angelongit/spot/docs/concept/concept_b_hex.png

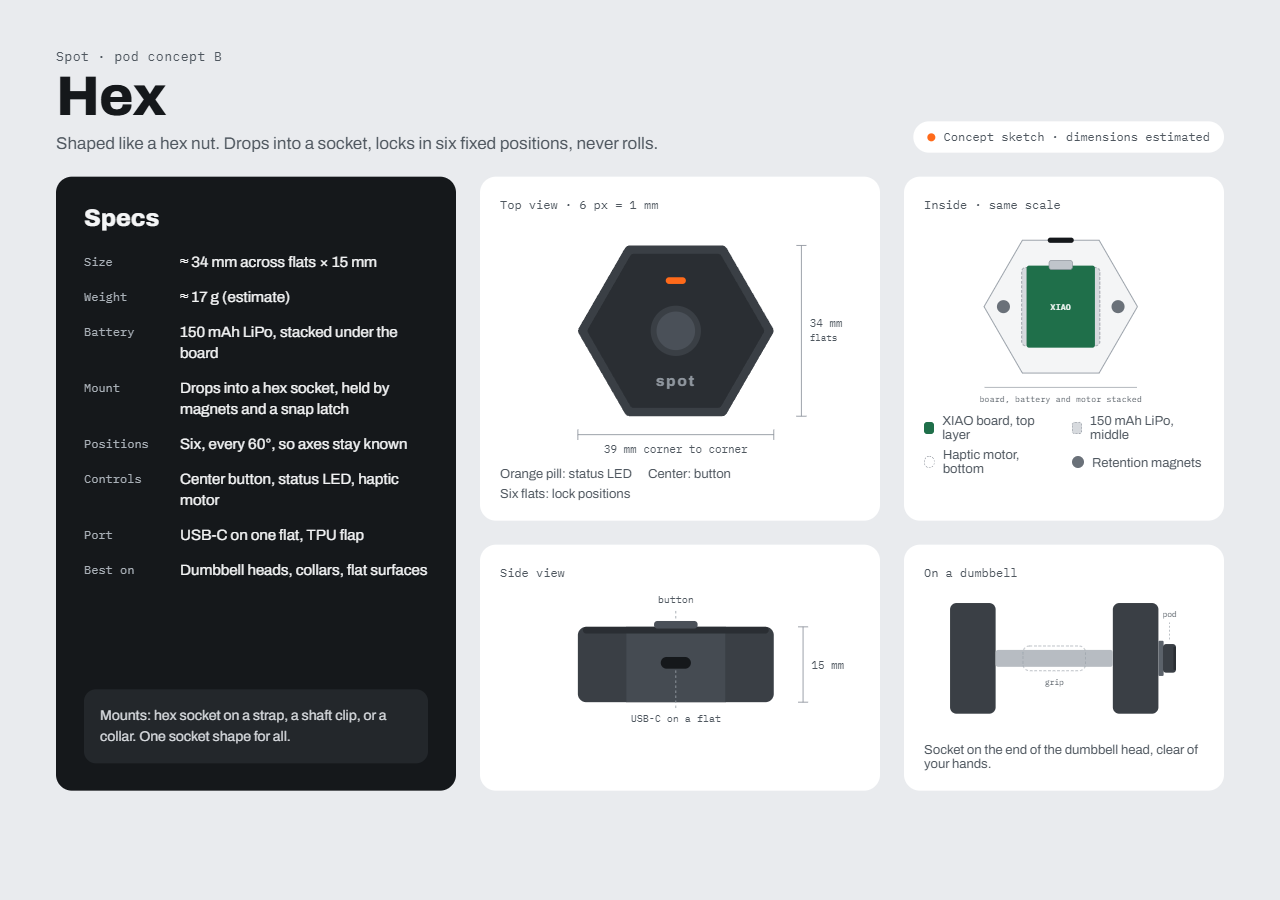
docs/concept/concept_b_hex.png
