angelongit/spot/docs/concept/hex_on_machines.png

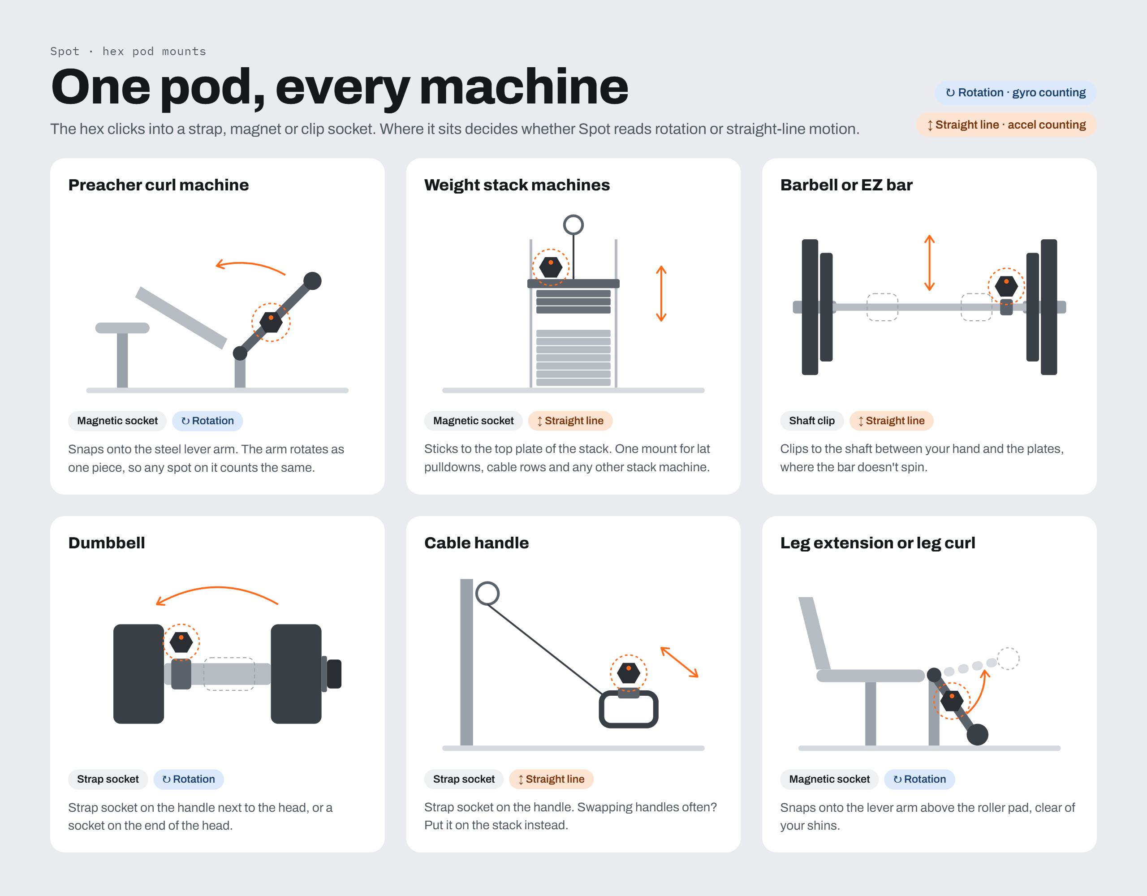
docs/concept/hex_on_machines.png
