angelongit/spot/docs/Spot_Test_Log_v1.2.xlsx

Sheet: Summary
Spot v1 test results (held-out data only)
Calculated from the other tabs. Only rows marked Held-out = Yes are counted. Do not edit this tab.
Measure | Curl | Raise | Press
R1 · held-out sets scored | 0 | 0 | 0
R1 · % of sets within ±1 (need ≥ 90%)
R1 · sets outside ±2 (need 0) | 0 | 0 | 0
R1 · PASS (≥ 27 sets, ≥ 90% within ±1, none outside ±2) | — | — | —
R4 · Spot mean absolute error
R4 · watch mean absolute error
R4 · PASS (Spot error lower than watch) | — | — | —
R3 · rest periods scored | 0 | 0 | 0
R3 · % within ±5 s (need ≥ 90%)
R3 · PASS (≥ 20 rests, ≥ 90% within ±5 s) | — | — | —
R2 · noise sets scored | 0 | 0 | 0
R2 · noise sets failed (need 0) | 0 | 0 | 0
R2 · PASS (≥ 20 sets, none failed) | — | — | —
R6a · % of reps within ±0.5 s (need ≥ 90%)
R6b · % of video partials logged as partials (need ≥ 90%)
R6b · % of full reps logged as partials (need ≤ 10%)
R6c · % of momentum reps flagged (need ≥ 80%)
R6c · % of clean reps flagged as momentum (need ≤ 10%)
Partials are not counted as reps. For the press, R6c momentum means a rebound off the chest. R5 and R7 are pass/fail checks recorded in the Project Log.

Sheet: How to use
How to use this test log
• Fill in only the light-orange cells. Row 2 of each tab (grey) is an example with Held-out = Example; it is never scored.
• White cells are formulas. Do not type over them.
• One row per set (R1 sets), per rest period (R3 rest), per noise recording (R2 noise) and per rep (R6 reps).
• Count reps on the video BEFORE looking at Spot's count, and type the video count first.
• Held-out? = Yes only for sets recorded after the counter was frozen (Git tag). Everything earlier is tuning data: mark it No.
• R1 sets: Difference = Spot count − video count. Watch count is only for R4; leave it blank otherwise.
• R3 rest: rest boundaries come from the video's counted reps, not Spot's. Mark Excluded? = Yes for any rest over 5 minutes, decided before scoring.
• R2 noise: Pass needs Spot count = 0 and Started a set? = No.
• R6 reps: one row per movement (full rep or partial). Video label is clean, momentum or partial, judged on video before looking at Spot's data. Rep duration (R6a) is scored on full reps only. Mark Excluded? = Yes for a rep the video shows did not follow its set type, decided before scoring.
• R1 sets: the video count is full reps only (momentum reps included). Partials go in the Video partials column.
• The Summary tab applies the pass rules from Spot — Requirements v1.0.
File name rule (see data/README.md): <exercise>_<hand>_<speed>_<form>_<NN>reps_<YYYYMMDD>_<HHMM>.csv, for example curl_R_normal_mixed_08reps_20261102_1405.csv

Sheet: R1 sets
Set ID | Date | File name | Exercise | Speed | Form | Planned reps | Video count (full reps) | Spot count | Difference (Spot − video) | Within ±1 | Within ±2 | Held-out? | Watch count (R4) | Watch error | Spot error | Hand | Video partials | Spot partials | Notes
EXAMPLE | 2026-11-02 | curl_R_normal_mixed_08reps_20261102_1405.csv | curl | normal | mixed | 8 | 8 | 9 | 1 | Yes | Yes | Example | 7 | 1 | 1 | R | 3 | 3 | Example row, not scored

Sheet: R3 rest
Rest ID | Exercise | Set before (ID) | Set after (ID) | Video rest (s) | Spot rest (s) | Difference (s) | Within ±5 s | Held-out? | Excluded? | Notes
EXAMPLE | curl | C-01 | C-02 | 92.4 | 95.1 | 2.7 | Yes | Example | No | Example row, not scored

Sheet: R2 noise
Noise ID | Mode | File name | Noise types | Between real sets? | Length (s) | Spot count | Started a set? | Pass | Held-out? | Notes
EXAMPLE | curl | curl_noise_pickup-carry_20261102_1420.csv | pick up, carry | No | 45 | 0 | No | Yes | Example | Example row, not scored

Sheet: R6 reps
Set ID | Movement # | Exercise | Video label | Video duration (s) | Spot duration (s) | Difference (s) | Within ±0.5 s | Spot logged as partial | LED cue correct? | Excluded? | Held-out? | Spot momentum flag | Notes
EXAMPLE | 1 | curl | momentum | 2.1 | 2.32 | 0.22 | Yes | No |  | No | Example | Yes | Example row, not scored
