angelongit/spot/data/tuning/Dumbbell_Curls/Initial_Testing/curl_momentum_10reps_20261016_210242.csv

t_ms | ax | ay | az | gx | gy | gz
1461191 | 0.214 | 0.971 | -0.109 | 0.00 | -2.52 | -2.80
1461201 | 0.217 | 0.965 | -0.108 | 0.35 | -2.94 | -3.01
1461211 | 0.218 | 0.960 | -0.109 | 0.91 | -3.29 | -3.57
1461220 | 0.220 | 0.956 | -0.108 | 1.40 | -3.64 | -4.13
1461230 | 0.224 | 0.954 | -0.105 | 1.54 | -3.64 | -4.48
1461240 | 0.224 | 0.951 | -0.107 | 2.03 | -3.78 | -4.27
1461250 | 0.224 | 0.952 | -0.107 | 2.87 | -3.92 | -2.80
1461260 | 0.232 | 0.961 | -0.108 | 3.43 | -3.99 | -0.56
1461270 | 0.233 | 0.962 | -0.107 | 4.20 | -3.92 | 1.75
1461280 | 0.231 | 0.960 | -0.111 | 4.62 | -3.71 | 3.92
1461290 | 0.231 | 0.959 | -0.113 | 5.53 | -3.71 | 6.23
1461300 | 0.233 | 0.962 | -0.111 | 5.88 | -3.57 | 8.05
1461311 | 0.232 | 0.962 | -0.111 | 6.37 | -3.43 | 10.15
1461321 | 0.229 | 0.963 | -0.114 | 7.14 | -3.29 | 11.76
1461334 | 0.231 | 0.966 | -0.116 | 7.49 | -3.29 | 12.67
1461344 | 0.232 | 0.969 | -0.118 | 7.70 | -3.15 | 12.88
1461354 | 0.229 | 0.968 | -0.119 | 7.77 | -3.08 | 12.67
1461363 | 0.224 | 0.974 | -0.119 | 8.05 | -3.22 | 11.83
1461373 | 0.221 | 0.976 | -0.118 | 8.05 | -3.36 | 10.57
1461383 | 0.214 | 0.978 | -0.115 | 8.19 | -3.64 | 9.31
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
