angelongit/spot/data/tuning/Dumbbell_Curls/Initial_Testing/curl_normal_set_10_reps.csv

t_ms | ax | ay | az | gx | gy | gz
5677 | -0.074 | 0.995 | 0.001 | 2.94 | -7.00 | -0.21
5687 | -0.074 | 0.996 | -0.001 | 3.15 | -6.86 | 0.00
5697 | -0.073 | 0.996 | 0.003 | 3.36 | -6.79 | 0.77
5707 | -0.075 | 0.997 | 0.000 | 3.29 | -6.72 | 1.26
5718 | -0.078 | 0.996 | 0.003 | 3.64 | -6.72 | 1.96
5727 | -0.082 | 0.995 | 0.005 | 3.78 | -6.86 | 2.45
5737 | -0.084 | 0.991 | 0.004 | 3.78 | -7.00 | 2.87
5746 | -0.087 | 0.990 | 0.004 | 4.27 | -7.42 | 3.57
5756 | -0.093 | 0.989 | 0.005 | 4.13 | -7.77 | 4.48
5766 | -0.100 | 0.990 | 0.008 | 4.41 | -8.26 | 5.53
5776 | -0.107 | 0.993 | 0.008 | 4.97 | -9.17 | 6.65
5785 | -0.114 | 0.991 | 0.009 | 5.11 | -10.01 | 7.77
5795 | -0.117 | 0.994 | 0.013 | 5.39 | -11.34 | 9.03
5805 | -0.123 | 0.993 | 0.011 | 5.95 | -12.53 | 9.59
5815 | -0.128 | 0.992 | 0.011 | 6.30 | -13.79 | 9.73
5825 | -0.133 | 0.989 | 0.009 | 6.30 | -15.19 | 9.03
5834 | -0.140 | 0.987 | 0.009 | 6.51 | -16.73 | 7.77
5844 | -0.143 | 0.986 | 0.006 | 5.88 | -18.13 | 6.79
5854 | -0.145 | 0.987 | 0.006 | 5.46 | -19.53 | 5.67
5863 | -0.145 | 0.989 | 0.004 | 4.76 | -21.28 | 4.83
5874 | -0.142 | 0.991 | -0.000 | 4.34 | -22.61 | 4.55
5884 | -0.136 | 0.994 | 0.002 | 3.64 | -23.80 | 5.25
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
