angelongit/spot/data/tuning/Dumbbell_Curls/Initial_Testing/curl_normal_set_12_reps.csv

t_ms | ax | ay | az | gx | gy | gz
820802 | 0.859 | -0.469 | 0.078 | -3.85 | -2.87 | 9.03
820812 | 0.862 | -0.467 | 0.076 | -3.29 | -3.08 | 10.92
820822 | 0.864 | -0.464 | 0.068 | -3.29 | -3.08 | 12.11
820832 | 0.869 | -0.468 | 0.068 | -2.73 | -3.08 | 12.88
820841 | 0.879 | -0.472 | 0.068 | -2.45 | -3.08 | 13.58
820851 | 0.885 | -0.476 | 0.066 | -2.31 | -3.01 | 13.44
820861 | 0.886 | -0.473 | 0.065 | -1.96 | -2.80 | 12.60
820872 | 0.884 | -0.470 | 0.061 | -1.89 | -2.59 | 11.83
820881 | 0.887 | -0.468 | 0.061 | -1.68 | -2.24 | 11.48
820892 | 0.891 | -0.471 | 0.063 | -1.54 | -1.96 | 11.27
820902 | 0.896 | -0.474 | 0.063 | -1.54 | -1.68 | 11.34
820911 | 0.896 | -0.472 | 0.063 | -2.03 | -1.40 | 11.27
820922 | 0.897 | -0.470 | 0.067 | -2.17 | -1.26 | 10.78
820931 | 0.897 | -0.468 | 0.070 | -2.73 | -1.33 | 9.59
820942 | 0.896 | -0.462 | 0.072 | -3.50 | -1.26 | 7.98
820951 | 0.895 | -0.455 | 0.075 | -4.97 | -1.26 | 6.30
820961 | 0.893 | -0.447 | 0.082 | -6.23 | -1.26 | 4.48
820971 | 0.887 | -0.444 | 0.083 | -7.56 | -1.19 | 2.66
820981 | 0.884 | -0.434 | 0.083 | -8.89 | -1.26 | 1.05
820991 | 0.879 | -0.432 | 0.082 | -10.29 | -1.26 | 0.21
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
