angelongit/spot/data/tuning/Dumbbell_Curls/Initial_Testing/curl_normal_set_8_reps.csv

t_ms | ax | ay | az | gx | gy | gz
778913 | 0.610 | -0.791 | -0.043 | 1.75 | -10.01 | 0.77
778923 | 0.610 | -0.793 | -0.044 | 1.89 | -10.08 | 1.26
778933 | 0.608 | -0.795 | -0.045 | 1.89 | -10.15 | 1.89
778942 | 0.611 | -0.798 | -0.046 | 2.10 | -10.22 | 2.73
778952 | 0.610 | -0.802 | -0.044 | 1.89 | -10.15 | 3.50
778961 | 0.610 | -0.800 | -0.045 | 2.10 | -10.08 | 3.85
778971 | 0.609 | -0.798 | -0.044 | 2.17 | -10.08 | 3.99
778981 | 0.609 | -0.800 | -0.045 | 2.17 | -10.15 | 3.71
778991 | 0.602 | -0.799 | -0.040 | 2.24 | -10.01 | 3.15
779001 | 0.603 | -0.796 | -0.042 | 2.17 | -9.87 | 2.17
779011 | 0.600 | -0.793 | -0.042 | 2.03 | -9.80 | 1.26
779021 | 0.602 | -0.790 | -0.044 | 2.24 | -9.66 | 0.56
779031 | 0.601 | -0.793 | -0.044 | 2.38 | -9.59 | 0.28
779040 | 0.606 | -0.795 | -0.043 | 2.31 | -9.17 | 0.56
779050 | 0.616 | -0.800 | -0.043 | 2.59 | -8.89 | 1.33
779060 | 0.621 | -0.802 | -0.040 | 2.59 | -8.40 | 2.24
779070 | 0.628 | -0.807 | -0.035 | 2.80 | -7.84 | 3.50
779079 | 0.633 | -0.809 | -0.035 | 2.94 | -7.07 | 4.62
779089 | 0.637 | -0.804 | -0.031 | 3.36 | -6.23 | 5.53
779099 | 0.643 | -0.805 | -0.029 | 3.29 | -5.32 | 6.02
779109 | 0.647 | -0.805 | -0.026 | 3.57 | -4.34 | 6.37
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
