angelongit/spot/data/tuning/Dumbbell_Curls/Initial_Testing/curl_partial_10reps_20261016_211012.csv

t_ms | ax | ay | az | gx | gy | gz
1899732 | 0.932 | 0.370 | 0.037 | -4.13 | -4.13 | -3.85
1899742 | 0.934 | 0.363 | 0.038 | -3.92 | -4.06 | -2.73
1899751 | 0.934 | 0.361 | 0.039 | -3.64 | -4.13 | -1.96
1899762 | 0.933 | 0.352 | 0.039 | -3.43 | -3.85 | -1.19
1899772 | 0.937 | 0.348 | 0.040 | -3.08 | -3.64 | -0.21
1899782 | 0.938 | 0.346 | 0.048 | -2.59 | -3.50 | 0.21
1899792 | 0.941 | 0.340 | 0.048 | -2.17 | -3.36 | 0.70
1899802 | 0.944 | 0.336 | 0.053 | -2.03 | -3.15 | 0.98
1899812 | 0.946 | 0.335 | 0.057 | -1.54 | -3.08 | 1.19
1899821 | 0.952 | 0.332 | 0.056 | -1.26 | -3.15 | 1.33
1899831 | 0.957 | 0.333 | 0.061 | -0.84 | -3.22 | 1.82
1899841 | 0.965 | 0.335 | 0.066 | -0.42 | -3.29 | 2.31
1899850 | 0.967 | 0.336 | 0.067 | -0.35 | -3.50 | 2.87
1899860 | 0.966 | 0.338 | 0.066 | 0.14 | -3.57 | 3.01
1899870 | 0.965 | 0.340 | 0.067 | 0.21 | -3.85 | 3.15
1899880 | 0.962 | 0.342 | 0.067 | 0.49 | -4.13 | 3.15
1899890 | 0.959 | 0.342 | 0.064 | 0.77 | -4.20 | 2.73
1899900 | 0.949 | 0.346 | 0.062 | 0.91 | -4.34 | 2.38
1899910 | 0.946 | 0.345 | 0.063 | 1.26 | -4.48 | 1.82
1899920 | 0.941 | 0.344 | 0.062 | 1.40 | -4.76 | 1.40
1899929 | 0.939 | 0.342 | 0.062 | 1.82 | -4.83 | 1.12
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
