angelongit/spot/data/tuning/Dumbbell_Curls/Initial_Testing/curls_incomplete_error.csv

t_ms | ax | ay | az | gx | gy | gz
3714717 | 0.982 | -0.091 | -0.016 | 7.21 | -4.48 | 2.38
3714732 | 0.980 | -0.086 | -0.013 | 7.28 | -4.97 | 5.04
3714747 | 0.977 | -0.077 | -0.011 | 7.00 | -5.67 | 6.79
3714763 | 0.980 | -0.074 | -0.009 | 6.09 | -6.30 | 7.63
3714778 | 0.981 | -0.070 | -0.012 | 4.97 | -7.07 | 7.63
3714792 | 0.986 | -0.067 | -0.015 | 3.92 | -7.63 | 7.35
3714806 | 0.992 | -0.061 | -0.018 | 2.31 | -8.05 | 7.14
3714821 | 0.996 | -0.058 | -0.020 | 0.70 | -8.61 | 7.63
3714836 | 1.006 | -0.058 | -0.024 | -0.63 | -9.24 | 8.61
3714852 | 1.007 | -0.053 | -0.033 | -2.03 | -9.80 | 9.03
3714866 | 0.998 | -0.050 | -0.037 | -3.43 | -10.57 | 8.68
3714880 | 0.988 | -0.044 | -0.040 | -4.90 | -11.20 | 7.00
3714895 | 0.974 | -0.038 | -0.046 | -6.79 | -11.55 | 3.99
3714911 | 0.968 | -0.037 | -0.052 | -7.98 | -11.69 | 2.80
3714925 | 0.971 | -0.032 | -0.057 | -9.17 | -11.34 | 4.41
3714940 | 0.984 | -0.029 | -0.060 | -9.80 | -10.85 | 7.35
3714954 | 0.982 | -0.028 | -0.061 | -10.71 | -10.36 | 9.94
3714969 | 0.976 | -0.036 | -0.061 | -11.41 | -10.08 | 11.06
3714984 | 0.973 | -0.040 | -0.054 | -12.95 | -10.78 | 10.78
3715000 | 0.977 | -0.050 | -0.046 | -14.63 | -11.83 | 8.40
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
