angelongit/spot/data/tuning/No_Dumbell/First_5_Rep_Recordings.png

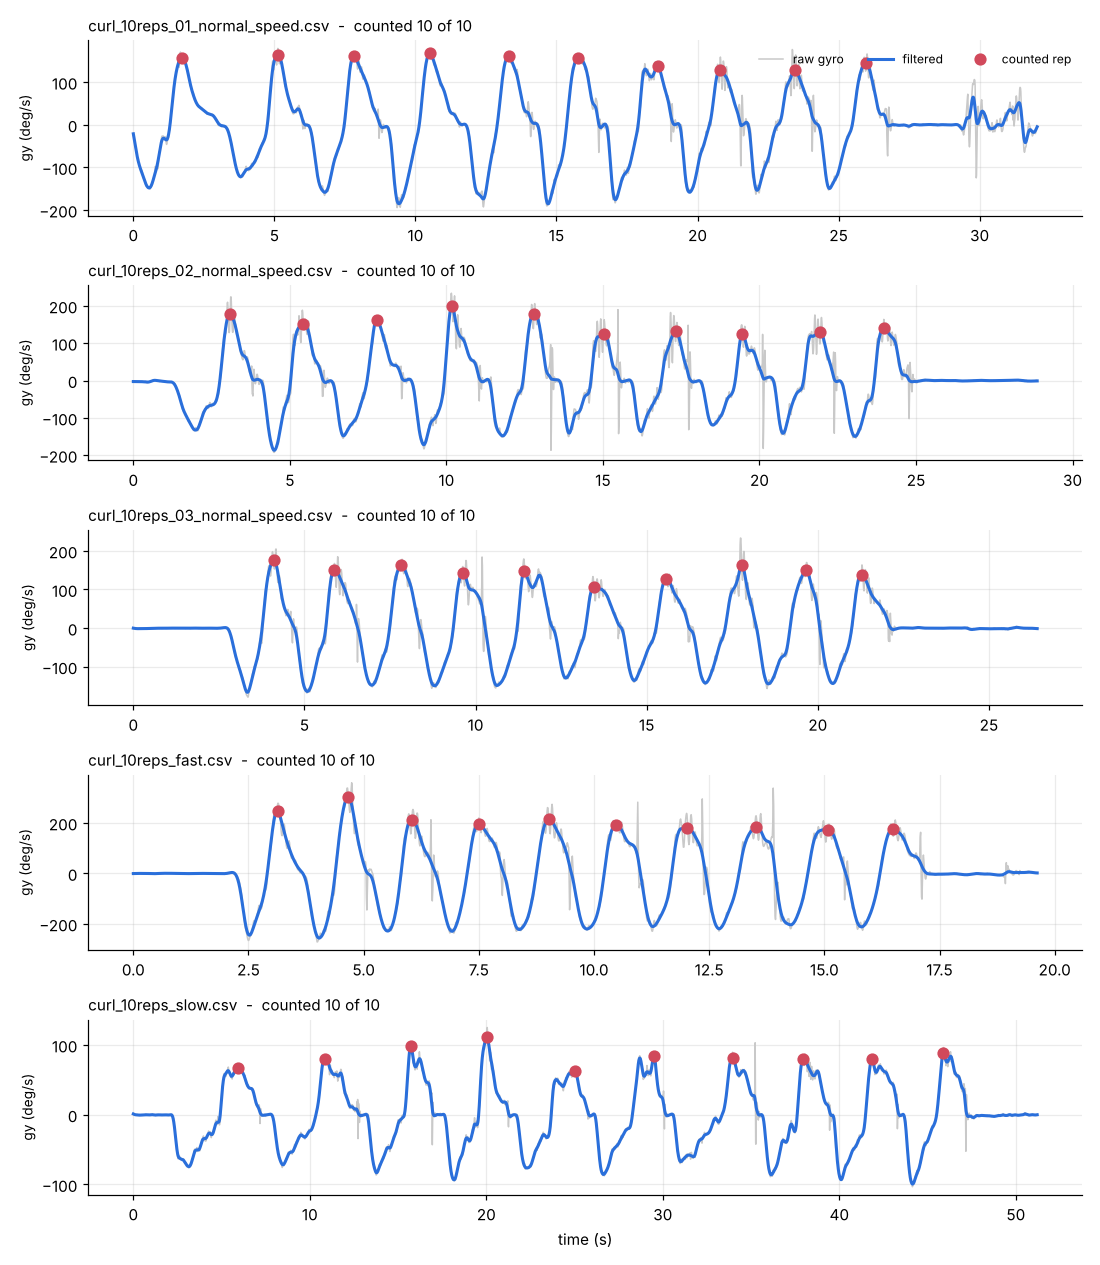
data/tuning/No_Dumbell/First_5_Rep_Recordings.png
