angelongit/spot/docs/Spot_Project_Log.docx

# Spot — Project Log

Oct 19, 2026 · Angel Lopez

A running engineering notebook. One entry per work session, newest at the top. Write it fast and honestly, including failures. Polish comes later in other docs.

## Entry template

Copy this block for each new session.

### YYYY-MM-DD — Short title of what you worked on

What I did

What you built, tried, wired, coded, or read.

What happened

Results: numbers, plots, photos, serial output. Paste screenshots here.

What I learned / what broke

Surprises, dead ends, bugs and their causes.

Next step

The first thing to do next session.

## Entries

### 2026-10-21 — Requirements v1.3, decision log and GitHub

What I did

Wrote Spot — Requirements over two sessions (Oct 20–21), now at v1.3. Every must-have has a number and a way to fail it: R1 counting full reps for the curl, lateral raise and chest press; R2 noise rejection; R3 rest timing; R4 beating my Garmin Forerunner 165; R5 the mode button; R6 rep duration, partial detection and momentum flagging; R7 logging with no USB cable.

I also added definitions for every term the tests use, plus gym and technical glossaries so someone who doesn't lift can follow along. I started DECISIONS.md, a test log spreadsheet and a data README with a file-naming rule, then pushed everything to GitHub.

What happened

Main decisions: video is the ground truth, and I count reps before looking at Spot's number. Only held-out sets, recorded after the counter is frozen with a Git tag, are scored. Rep count must be within ±1 on 90% of sets and ±2 on every set, over 27 sets per exercise: 3 speeds × clean, momentum and mixed sets, split across both hands.

Partial reps don't count, but Spot flags them. Momentum reps count, and Spot flags them too. Rest must be within ±5 s, and Spot must count zero reps on 20 noise sets per mode. v1 is tested at home on my own dumbbells but has to work as if it were at a gym; making it gym-ready is the goal for v2.

The mount plan changed to a steel plate stuck to the end face with VHB tape and held by magnets, after a fridge magnet didn't hold and the strap socket blocked my grip. Checking my recordings, the XIAO logger runs at 100 Hz, and gyro Z carries the curl at about 4.5–5× the next axis across full sets.

What I learned / what broke

Writing "how I'll test it" for each requirement exposed gaps: rest had no defined start or end, the press had a zone between "partial" and "full" that was neither, and 18 test sets meant 90% actually required 17 of 18. Tuning and scoring on the same data would overstate accuracy, which is why the frozen-counter rule exists.

Deciding that partials don't count made the press the riskiest part of v1: Spot has to tell a full press from a partial using only the accelerometer, since the press doesn't rotate. The 2 MB on-board flash holds only about 22–29 minutes of raw data, so a full test session might not fit.

Next step

Record USB tuning data for the lateral raise and chest press, and check the press data first to see whether full and partial presses can be told apart.

### 2026-10-19 — Backfill: How Spot Started

What I did

The project started as a solution to a problem I’ve had in the gym for a while. When lifting, I have a hard time accurately counting the number of repetitions I am performing due to focusing on the actual movement. This can become a problem when I’m trying to measure progress, so I started thinking about possible solutions.

I tried using my fitness watch’s workout feature, but it provided inaccurate results. The nature of wearables makes it difficult for them to count accurately, as they focus on wrist/arm movement and cannot ‘see’ the weight move. I decided that a wearable could potentially repeat the same problems I had already experienced.

This is when the idea to create a mountable device that does the counting for me was born. At first, the device was purely meant to count reps, but this didn’t seem worth the trouble as I could just record the set or get used to counting. To justify the project, I began thinking about other problems I have in the gym.

I proposed the idea to a couple of members of my organizations, and they agreed that it would be a good feature as they struggle with keeping form in check, especially later in the workout. After asking around, I landed on four core issue points to build the project around: Form Checking, Rep Timing, Rep Uniformity and Automatic Rest Detection.

After researching similar products to perform a ‘competitor analysis’, I found similar products that provided some features that I wanted. While the products could potentially be seen as competitors, none of them combined all the features in one device.

Rogo, a device created at my school Texas A&M, was a similar product but was vague about its metrics, claiming that it uses ‘AI’ to track workouts. Additionally, its snap-on nature can get in the way during certain exercises, or flat out not work. This flaw inspired my idea to create swappable mounts for my device.

Another competitor, RepOne, provided many of the features I planned on incorporating in the project. However, this product is aimed at coaches, pricing out average consumers at a whopping $449. My product is aimed at the general gym-goer and will focus on helping them standardize their form with easy-to-understand metrics and feedback.

I wanted to create the project myself so I could understand the architecture behind this type of device, and fix problems that I have personally experienced at the gym. Additionally, understanding the mechanics behind the device allows me to add features and understand my own workouts more.

Tracking your progress in the gym is important, and this extends beyond just the number of reps performed. I wanted to create a device that keeps me accountable and informed, not just for the number of reps but how those reps are performed. My device, Spot, will track metrics based on four core facets: position, acceleration, rotation, and velocity. From these metrics, the device will be able to count reps, measure tempo, time rest, and check form.

The goal for the initial prototype is to count rep and rest times correctly against video, and more accurately than a fitness watch. You shouldn’t have to worry about numbers in the gym; let Spot do the heavy lifting for you.
